maccesch/custom-ruler/cad/beam.step

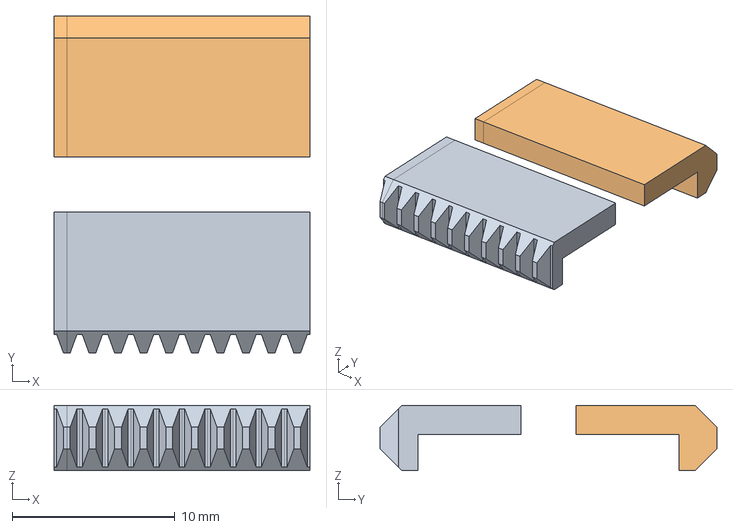
[picture p1: CAD file, 2026-10-28]
cad/beam.step
15.7 x 20.7 x 4.00 mm
