maccesch/custom-ruler/public/cad/pinion_cut_out.step

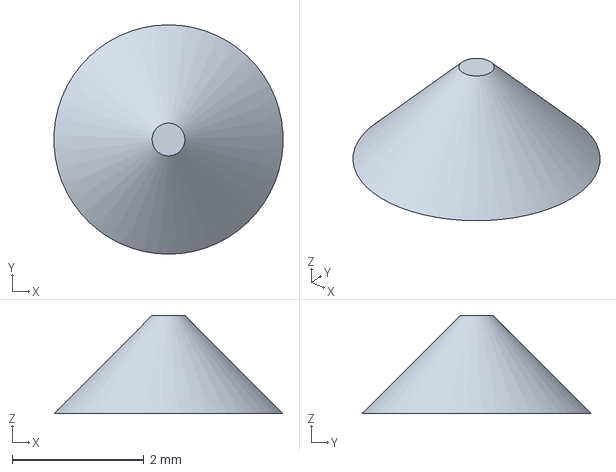
[picture p2: CAD file, 2026-10-28]
public/cad/pinion_cut_out.step
3.48 x 3.48 x 1.49 mm
