maccesch/custom-ruler/public/stl/needle.stl

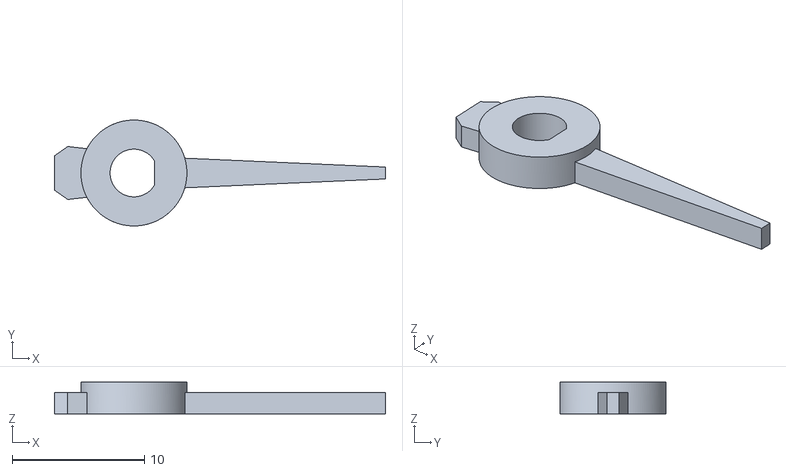
[picture p4: CAD file, 2026-10-28]
public/stl/needle.stl
25.0 x 8.00 x 2.40
