maccesch/custom-ruler/cad/pinion_axis.step

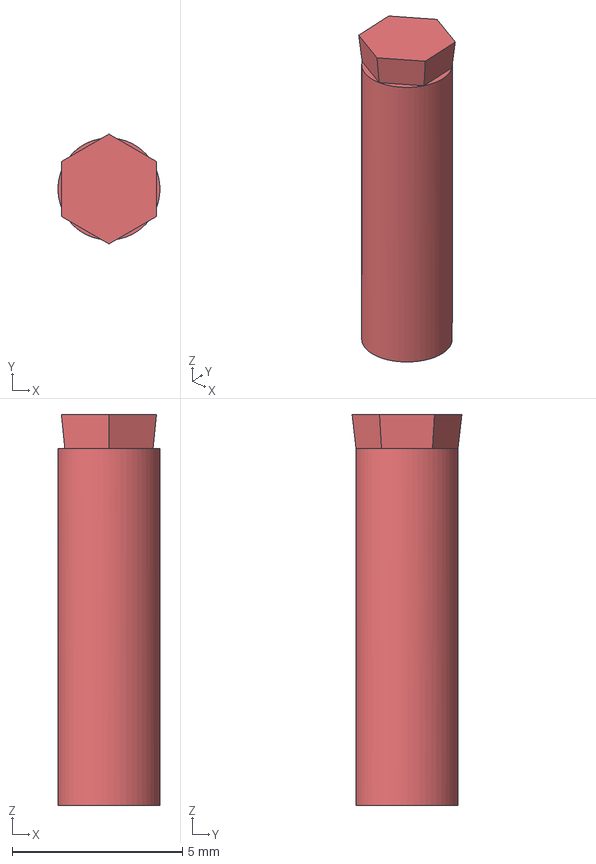
[picture p5: CAD file, 2026-10-28]
cad/pinion_axis.step
3.00 x 3.23 x 11.5 mm
