maccesch/custom-ruler/public/stl/bezel.stl

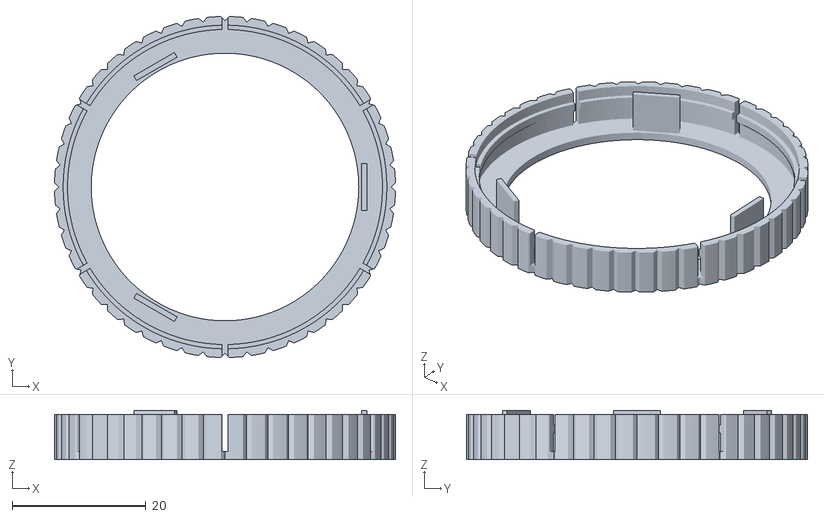
[picture p6: CAD file, 2026-10-28]
public/stl/bezel.stl
51.0 x 51.0 x 7.40
