maccesch/custom-ruler/public/stl/lock_screw.stl

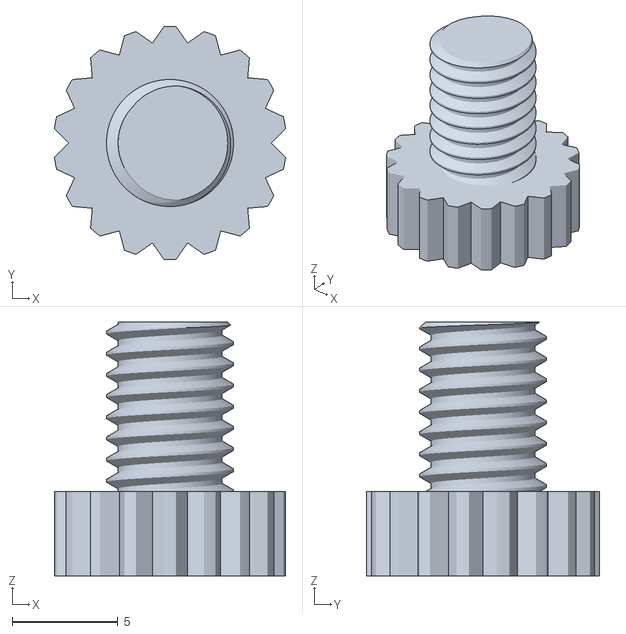
[picture p8: CAD file, 2026-10-28]
public/stl/lock_screw.stl
10.9 x 11.0 x 12.0
