maccesch/custom-ruler/(list of files, cad)

Other CAD files:
public/cad/top_bar.step
cad/top_bar.step
